baal86/ttgf-analog-openschnapp/xschem/README.txt

Do not use simulation -> LVS -> LVS netlist. Only: top level is subckt

Otherwise it will expand the MOSFETs and fail to locate the SPICE models
