baal86/ttgf-analog-openschnapp/docs/column_switch/README.md

## Column Switch
Select the column to be connected to the current source bus. The diode is only present to protect the large enable net during production (antenna diode).

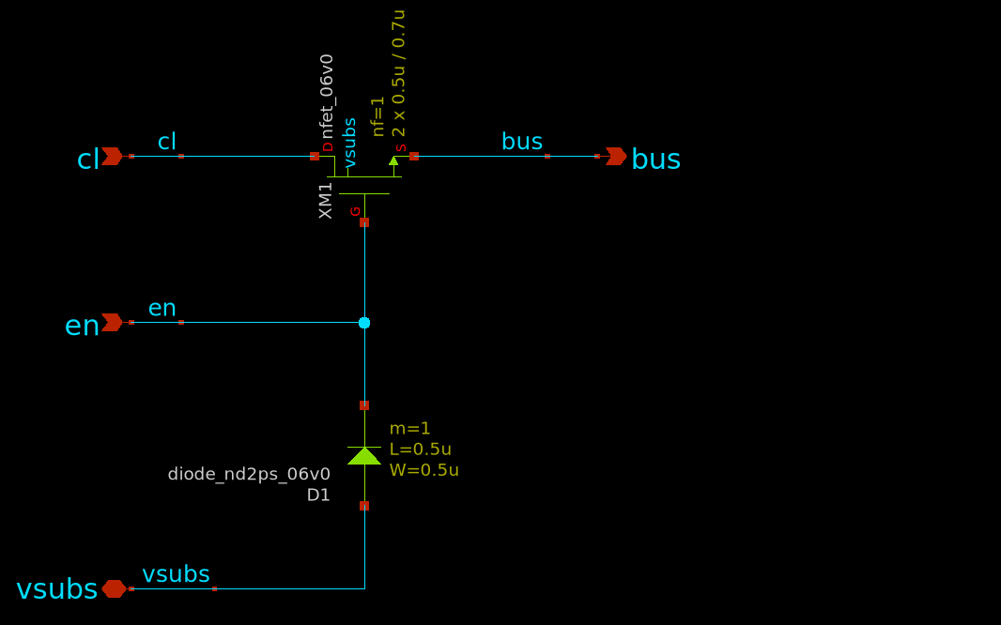
[picture p11: xschem/docs/ip_column_switch.png]
Schematics


### Transfer Function Simulation

AC transfer function is simulated. We aim for flat transfer function up to 1MHz when the switch is on and >80dB isolation when the switch is of. Note the significant difference in off-performance between ideal and post-layout simulation.

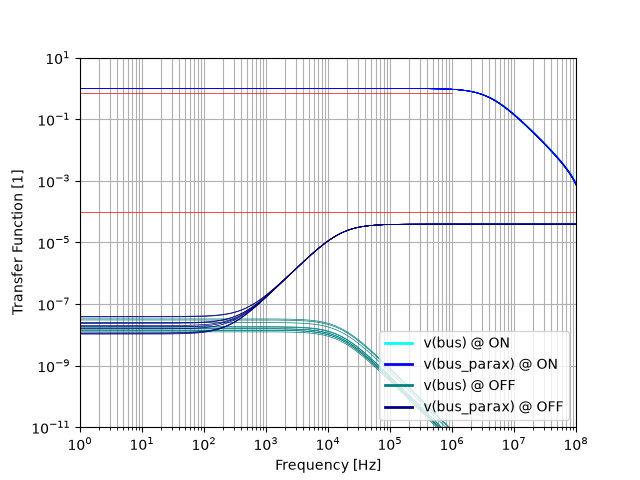
[picture p12: xschem/docs/tb_column_switch_ac.png]
AC Transfer Function
