baal86/ttgf-analog-openschnapp/docs/current_source/README.md

## Current Source
A low-side current source with two outputs, one for the pixel array, the other for the dummy pixel.

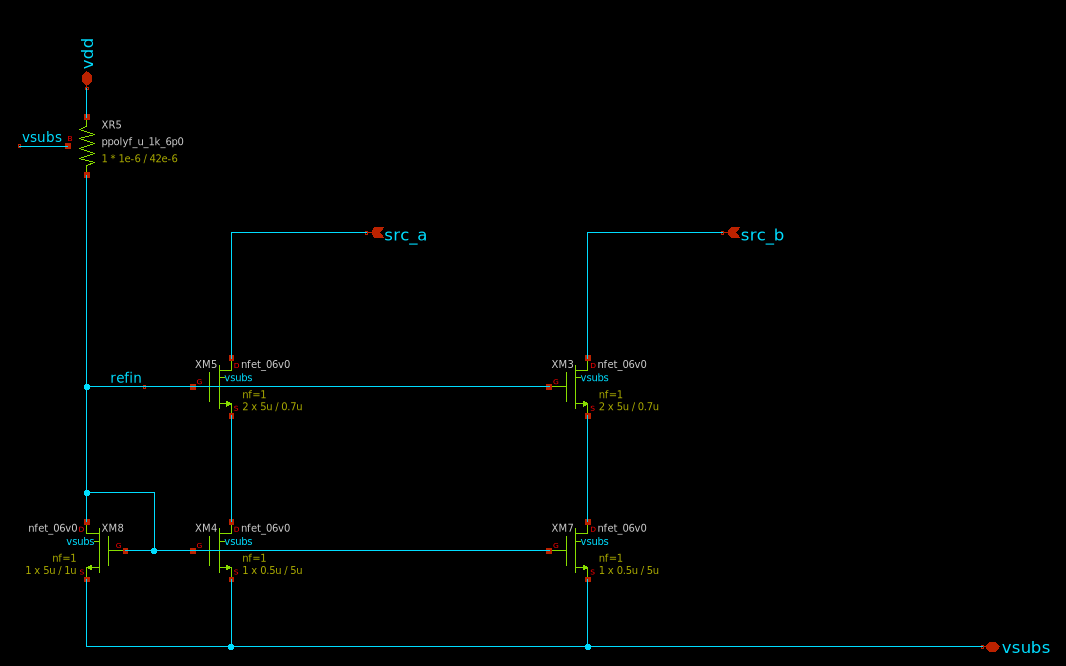
[picture p13: xschem/docs/ip_current_source.png]
Schematics


### Output Current Simulation

DC current output is simulated to be at 1uA under all conditions.

> View the test-bench on [https://xschem-viewer.com](https://xschem-viewer.com/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)

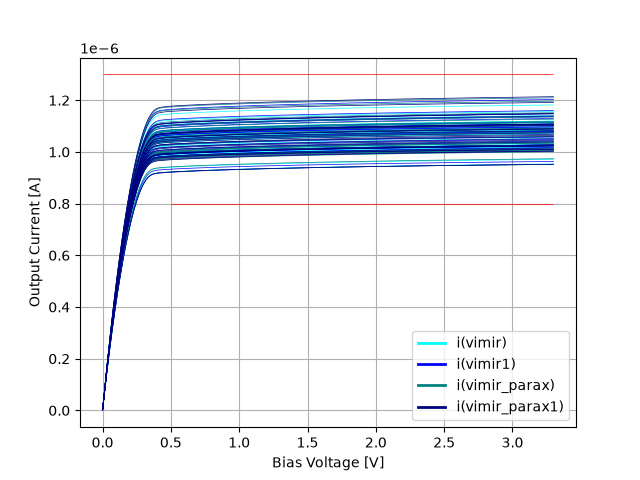
[picture p14: xschem/docs/tb_current_source_dc.png]
DC Current


### Output Impedance Simulation

Output impedance is simulated.

> View the test-bench on [https://xschem-viewer.com](https://xschem-viewer.com/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)

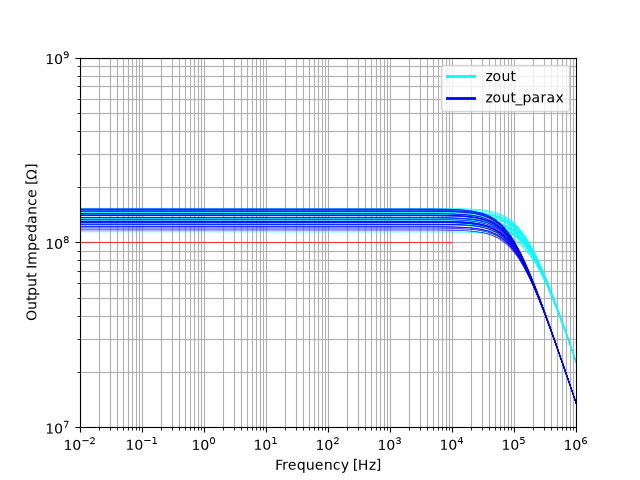
[picture p15: xschem/docs/tb_current_source_ac.png]
AC Impedance
