baal86/ttgf-analog-openschnapp/docs/total/README.md

## Total Simulation
A subset of the entire image sensor is simulated. This includes co-simulation of the digital parts.  The exposure time is 5ms, but injection currents are scaled up to compensate. A test pattern image is injected. The simulation implements correlated double sampling to compensate for the photons caught during integration and to reject kTC noise (not modelled).

> View the test-bench on [https://xschem-viewer.com](https://xschem-viewer.com/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)

A timing diagram of the digital signals, clock, reset, and column/row control is shown below.

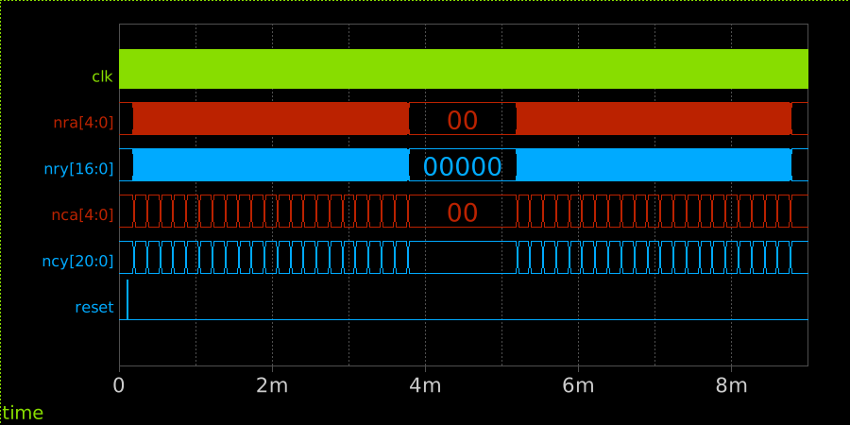
[picture p21: xschem/docs/tb_total_tran.a.png]
Timing Diagram


The analog signals are shown below:

- `ref` is the voltage of the reference pixel.
- `sf` is the unbuffered pixel voltage at the current source.
- `out` is the buffered video output.

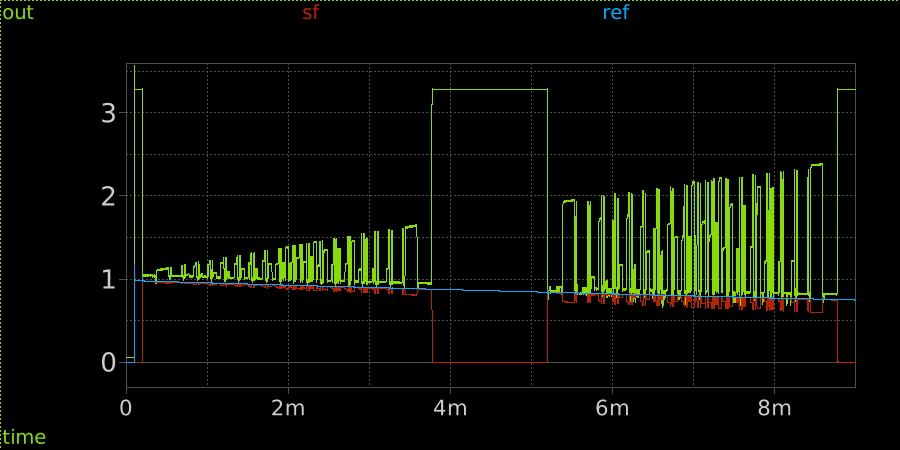
[picture p22: xschem/docs/tb_total_tran.b.png]
Analog Signals


The resulting image is shown below, quantized to 12bit @ 3.3V FSR as would be the case for the RP2350 ADC.

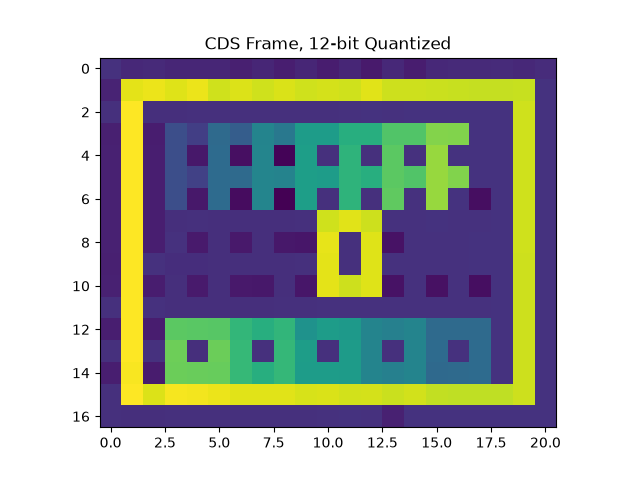
[picture p23: xschem/docs/tb_total_tran.png]
Samples Image
