baal86/ttgf-analog-openschnapp/docs/info.md

<!---

This file is used to generate your project datasheet. Please fill in the information below and delete any unused
sections.

You can also include images in this folder and reference them in the markdown. Each image must be less than
512 kb in size, and the combined size of all images must be less than 1 MB.
-->

## How it works

A classic 3T CMOS image sensor. Diode performance will be poor, but hopefully the readout can be demonstrated. 

Block Diagram

### Masked Pixels

Some pixel rows are masked by `metal5` power distribution structures generated by tiny tapeout, but the available pixels should allow characterization of the image sensor. `metal4` will be populated with a fine grid to hopefully prevent automatic filler generation in the pixel area on `metal4` and `metal5`. Unless the power bar generation algorithm changes from the TTGF-0p3 shuttle the following pixel rows should be available. There is an indicator bar on `metal4` next to the power distribution strips that indicates predicted `metal5` placement, solid bars being open and striped bars being masked.

| Rows  |  Status |
| ----- | --- |
| 16 | 🌑masked |
| 15,14 | 🌕open |
| 13 | 🌗50% open |
| 12,11 | 🌑masked |
| 10 | 🌗50% open |
| 9,8 | 🌕open |
| 7,6,5 | 🌑masked |
| 4,3 | 🌕open |
| 2 | 🌗50% open |
| 1,0 | 🌑masked |

So, in total, ~47% of pixels are masked, ~35% open and ~18% half-masked.

### Further Documentation

More documentation is avaialble in the repository itself. Further documentation for single IP blocks in the folders listed below.

- [https://github.com/baal86/ttgf-analog-openschnapp/blob/main/docs/pixel/README.md](https://github.com/baal86/ttgf-analog-openschnapp/blob/main/docs/pixel/README.md)
- [https://github.com/baal86/ttgf-analog-openschnapp/blob/main/docs/current_source/README.md](https://github.com/baal86/ttgf-analog-openschnapp/blob/main/docs/current_source/README.md)
- [https://github.com/baal86/ttgf-analog-openschnapp/blob/main/docs/column_mux/README.md](https://github.com/baal86/ttgf-analog-openschnapp/blob/main/docs/column_mux/README.md)
- [https://github.com/baal86/ttgf-analog-openschnapp/blob/main/docs/row_mux/README.md](https://github.com/baal86/ttgf-analog-openschnapp/blob/main/docs/row_mux/README.md)
- [https://github.com/baal86/ttgf-analog-openschnapp/blob/main/docs/column_switch/README.md](https://github.com/baal86/ttgf-analog-openschnapp/blob/main/docs/column_switch/README.md)
- [https://github.com/baal86/ttgf-analog-openschnapp/blob/main/docs/amplifier/README.md](https://github.com/baal86/ttgf-analog-openschnapp/blob/main/docs/amplifier/README.md)
- [https://github.com/baal86/ttgf-analog-openschnapp/blob/main/docs/signal_processing/README.md](https://github.com/baal86/ttgf-analog-openschnapp/blob/main/docs/signal_processing/README.md)
- [https://github.com/baal86/ttgf-analog-openschnapp/blob/main/docs/total/README.md](https://github.com/baal86/ttgf-analog-openschnapp/blob/main/docs/total/README.md)

## How to test

For simple uncorrelated readout:

- Apply a 200kHz clock to the `clk` pin of the chip. This synchronizes the column select, row select and reset signals.
- Pulse reset high, then low to reset the array using the `ui[5]` signal. The reset signal is latched at the rising edge of the chip clock.
- Wait for your desired integration time. Try 1ms to start with.
- Read out the image sensor. Do for each pixel in the array.
    - Address the pixel by row and column number using the `ui[4:0]` and `uio[4:0]` signals. Column and row select are latched at the rising edge of the chip clock.
    - After settling, sample the video output signal `ua[0]` or buffered signal `ua[1]` using the development board ADC. The falling edge of the chip clock is a suitable trigger signal, although it would be advantageous to choose a sample point right before the next pixel is addressed to maximize sample time.

More advanced readout modes like correlated double sampling (CDS) and up-the ramp should be possible but the capability of the image sensor for non-destructive read needs to be tested first for the latter.

The [overall simulation](https://github.com/baal86/ttgf-analog-openschnapp/blob/main/docs/total/README.md) shows example clock patters for correlated double sampling readout of the detector.
