baal86/ttgf-analog-openschnapp/docs/column_mux/README.md

## Column Multiplexer
A clock-synchronous 5:21 de-multiplexer that gives:

- No column activated if A[4:0] = 0b00000
- A single column activated for other values of A

The multiplexer is implemented in Verilog.

### Timing Diagram

Timing diagram to visualize functionality.

> View the test-bench on [https://xschem-viewer.com](https://xschem-viewer.com/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)

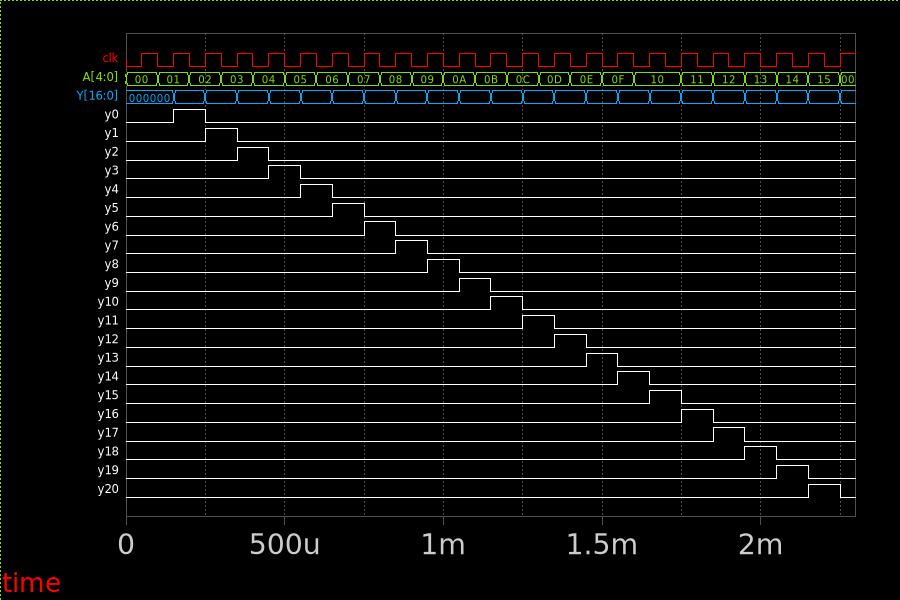
[picture p26: xschem/docs/tb_column_mux_timing.png]
Timing Diagram
