baal86/ttgf-analog-openschnapp/xschem/docs/ip_pixel_frame_right.png

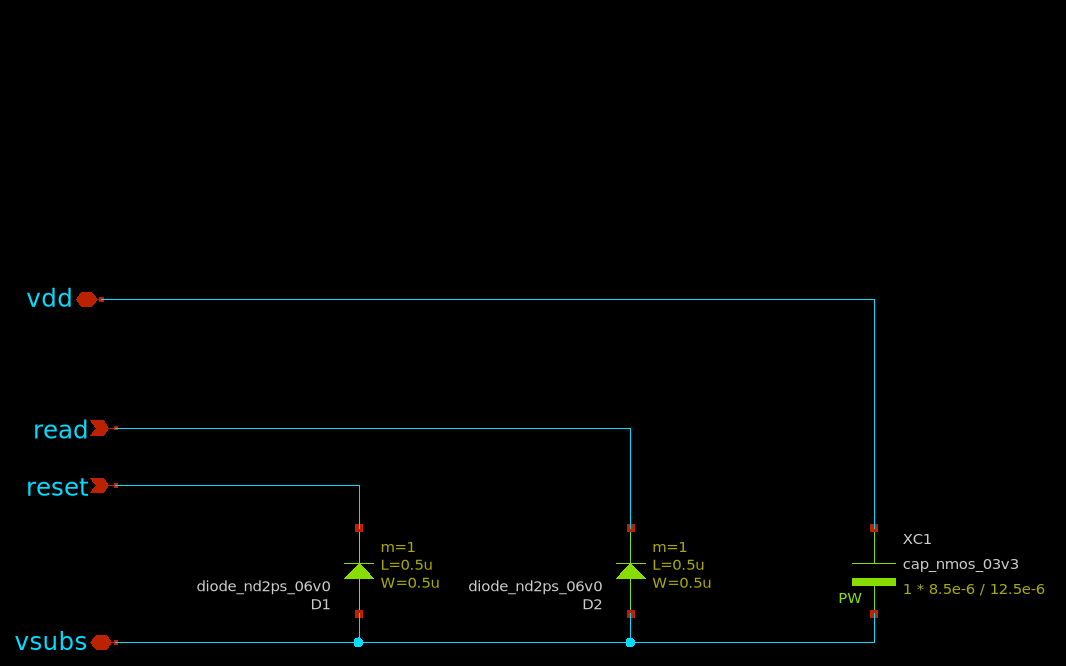
xschem/docs/ip_pixel_frame_right.png
