baal86/ttgf-analog-openschnapp/xschem/docs/ip_psucap_bottom.png

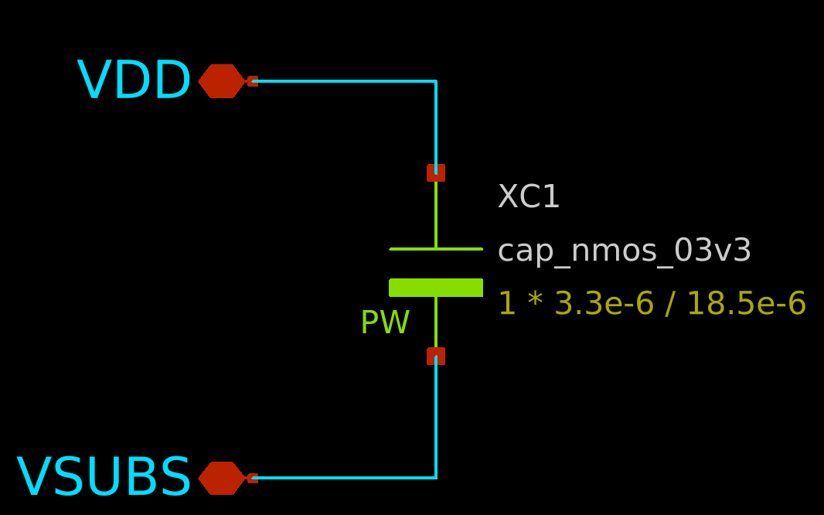
xschem/docs/ip_psucap_bottom.png
