baal86/ttgf-analog-openschnapp/xschem/docs/ip_psucap_br.png

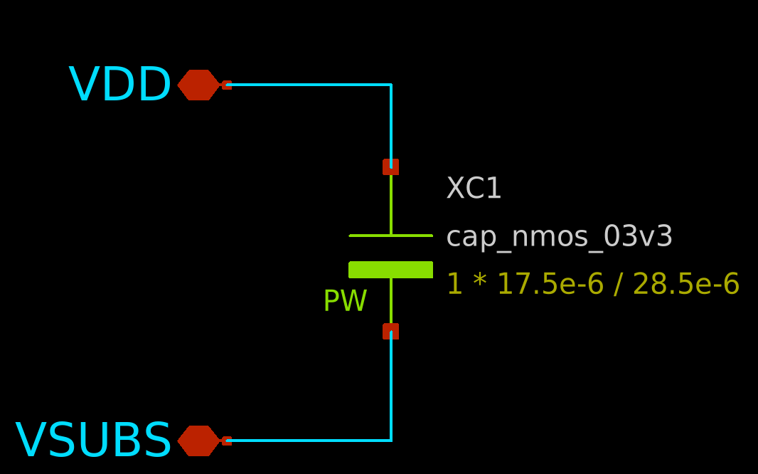
xschem/docs/ip_psucap_br.png
