baal86/ttgf-analog-openschnapp/xschem/lvs/ip_current_source.lvs.spice

** sch_path: /foss/designs/ttgf-analog-openschnapp/xschem/ip_current_source.sch
.subckt ip_current_source vdd src_a vsubs src_b
*.PININFO vdd:B vsubs:B src_a:I src_b:I
XM8 refin refin vsubs vsubs nfet_06v0 L=1u W=5u nf=1 ad='int((nf+1)/2) * W/nf * 0.18u' as='int((nf+2)/2) * W/nf * 0.18u' pd='2*int((nf+1)/2) * (W/nf + 0.18u)'
+ ps='2*int((nf+2)/2) * (W/nf + 0.18u)' nrd='0.18u / W' nrs='0.18u / W' sa=0 sb=0 sd=0
XM5 src_a refin net1 vsubs nfet_06v0 L=0.7u W=5u nf=1 ad='int((nf+1)/2) * W/nf * 0.18u' as='int((nf+2)/2) * W/nf * 0.18u' pd='2*int((nf+1)/2) * (W/nf + 0.18u)'
+ ps='2*int((nf+2)/2) * (W/nf + 0.18u)' nrd='0.18u / W' nrs='0.18u / W' sa=0 sb=0 sd=0 m=2
XM3 src_b refin net2 vsubs nfet_06v0 L=0.7u W=5u nf=1 ad='int((nf+1)/2) * W/nf * 0.18u' as='int((nf+2)/2) * W/nf * 0.18u' pd='2*int((nf+1)/2) * (W/nf + 0.18u)'
+ ps='2*int((nf+2)/2) * (W/nf + 0.18u)' nrd='0.18u / W' nrs='0.18u / W' sa=0 sb=0 sd=0 m=2
XM4 net1 refin vsubs vsubs nfet_06v0 L=5u W=0.5u nf=1 ad='int((nf+1)/2) * W/nf * 0.18u' as='int((nf+2)/2) * W/nf * 0.18u' pd='2*int((nf+1)/2) * (W/nf + 0.18u)'
+ ps='2*int((nf+2)/2) * (W/nf + 0.18u)' nrd='0.18u / W' nrs='0.18u / W' sa=0 sb=0 sd=0
XM7 net2 refin vsubs vsubs nfet_06v0 L=5u W=0.5u nf=1 ad='int((nf+1)/2) * W/nf * 0.18u' as='int((nf+2)/2) * W/nf * 0.18u' pd='2*int((nf+1)/2) * (W/nf + 0.18u)'
+ ps='2*int((nf+2)/2) * (W/nf + 0.18u)' nrd='0.18u / W' nrs='0.18u / W' sa=0 sb=0 sd=0
XR5 refin vdd vsubs ppolyf_u_1k_6p0 r_width=1e-6 r_length=42e-6
.ends
