baal86/ttgf-analog-openschnapp/verilog/gl/ip_column_mux.v

module ip_column_mux (clk,
    VDD,
    VSS,
    A,
    Y);
 input clk;
 inout VDD;
 inout VSS;
 input [4:0] A;
 output [20:0] Y;

 wire net1;
 wire net2;
 wire net3;
 wire net4;
 wire net5;
 wire net7;
 wire net8;
 wire net9;
 wire net10;
 wire net11;
 wire net12;
 wire net13;
 wire net14;
 wire net15;
 wire net16;
 wire net17;
 wire net18;
 wire net19;
 wire net20;
 wire net21;
 wire net22;
 wire net23;
 wire net24;
 wire net25;
 wire net26;
 wire net27;
 wire _00_;
 wire _01_;
 wire _02_;
 wire _03_;
 wire _04_;
 wire _05_;
 wire _06_;
 wire _07_;
 wire _08_;
 wire _09_;
 wire _10_;
 wire _11_;
 wire _12_;
 wire _13_;
 wire _14_;
 wire _15_;
 wire _16_;
 wire _17_;
 wire _18_;
 wire _19_;
 wire _20_;
 wire _21_;
 wire _22_;
 wire _23_;
 wire _24_;
 wire _25_;
 wire _26_;
 wire _27_;
 wire _28_;
 wire _29_;
 wire _30_;
 wire _31_;
 wire _32_;
 wire _33_;
 wire _34_;
 wire net6;
 wire net28;
 wire net29;
 wire net30;
 wire net31;
 wire net32;

 gf180mcu_fd_sc_mcu7t5v0__fill_1 FILLER_0_101 (.VDD(VDD),
    .VNW(VDD),
    .VPW(VSS),
    .VSS(VSS));
 gf180mcu_fd_sc_mcu7t5v0__fill_2 FILLER_0_104 (.VDD(VDD),
    .VNW(VDD),
    .VPW(VSS),
    .VSS(VSS));
 gf180mcu_fd_sc_mcu7t5v0__fill_1 FILLER_0_106 (.VDD(VDD),
    .VNW(VDD),
    .VPW(VSS),
    .VSS(VSS));
 gf180mcu_fd_sc_mcu7t5v0__fill_2 FILLER_0_150 (.VDD(VDD),
    .VNW(VDD),
    .VPW(VSS),
    .VSS(VSS));
 gf180mcu_fd_sc_mcu7t5v0__fillcap_4 FILLER_0_166 (.VDD(VDD),
    .VNW(VDD),
    .VPW(VSS),
    .VSS(VSS));
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
    .VPW(VSS),
    .VSS(VSS));
 gf180mcu_fd_sc_mcu7t5v0__buf_1 output8 (.I(net8),
    .Z(Y[10]),
    .VDD(VDD),
    .VNW(VDD),
    .VPW(VSS),
    .VSS(VSS));
 gf180mcu_fd_sc_mcu7t5v0__buf_1 output9 (.I(net9),
    .Z(Y[11]),
    .VDD(VDD),
    .VNW(VDD),
    .VPW(VSS),
    .VSS(VSS));
endmodule
