baal86/ttgf-analog-openschnapp/(commit log)

2026-08-24 One commit for privacy
    [ip_current_source.sch, ip_pixel_nd2ps.sch, tb_current_source.sch, tb_pixel_nd2ps.sch]
2026-08-24 Minimal change to update mail
    [tb_pixel_nd2ps.sch]
2026-08-25 Added pixel DC TF simulation and dropped reference current to 5uA
    [ip_current_source.sch, tb_pixel_nd2ps_dc.sch]
2026-08-25 Require the use of CTRL to fit graphs
    [tb_pixel_nd2ps_tran.sch]
2026-08-25 Fix LVS again by changing row select FET size
    [ip_pixel_nd2ps.sch]
2026-08-25 Added a noise sim. source follower FET needs to be larger!
    [ip_pixel_nd2ps.sch, tb_pixel_nd2ps_noise.sch]
2026-08-26 Added display of integral
    [tb_pixel_nd2ps_noise.sch]
2026-08-26 Stepped noise simulation with display @ 2.5V
    [tb_pixel_nd2ps_noise.sch]
2026-08-26 reduce load current and prevent inline editing .sch
    [ip_current_source.sch, tb_current_source.sch, tb_pixel_nd2ps_noise.sch]
2026-08-26 Transition to cascode at 1uA. Noise is better now and other simulations appear to work still.
    [ip_current_source.sch, tb_current_source.sch, tb_pixel_nd2ps_noise.sch, tb_pixel_nd2ps_tran.sch]
2026-08-26 fixed resistors choosing something producible
    [ip_current_source.sch]
2026-08-27 Bring current source to a more reasonable aspect ratio
    [ip_current_source.sch, tb_pixel_nd2ps_dc.sch]
2026-08-27 Added magic layout for current source block
2026-08-27 for manufacturability
    [ip_current_source.sch]
2026-08-27 Added parax for current source.
    [tb_current_source_ac.sch]
2026-08-27 Added MC simulation
    [ip_current_source.sch, tb_current_source_dc.sch]
2026-08-27 Less aggressive MC
    [tb_current_source_dc.sch]
2026-08-27 Full monte-carlo for the current source
    [tb_current_source_ac.sch, tb_current_source_dc.sch]
2026-08-27 transition sim to MC
    [tb_pixel_nd2ps_dc.sch]
2026-08-27 Cleaned tran sim
    [tb_pixel_nd2ps_tran.sch]
2026-08-27 Switch to custom area diode
    [ip_pixel_nd2ps.sch]
2026-08-27 hard-connect VRESET and VDD in xschem. Operating separate VDD and VRESET is not useful without extra protections.
    [ip_pixel_nd2ps.sch, tb_pixel_nd2ps_dc.sch, tb_pixel_nd2ps_noise.sch, tb_pixel_nd2ps_tran.sch]
2026-08-27 Increase size of SF MOSFET
    [ip_pixel_nd2ps.sch]
2026-08-27 clean up MOSFET data
2026-08-28 Added column switch
    [ip_column_switch.sch, tb_column_switch_ac.sch, tb_pixel_nd2ps_dc.sch, tb_pixel_nd2ps_noise.sch, tb_pixel_nd2ps_tran.sch]
2026-08-28 Fix column switch simulation
    [tb_column_switch_ac.sch]
2026-08-28 Column switch cell design
2026-08-28 Adjust column switch size
    [ip_column_switch.sch]
2026-08-28 Added 4:16 multiplexer block
    [ip_line_mux.sch, tb_line_mux.sch]
2026-08-28 migrate to Librelane
    [ip_line_mux.sch, pin_order.cfg, tb_line_mux.sch]
2026-08-28 Added make view and experimenting with die space
    [pin_order.cfg]
2026-08-31 Squeezed the mux a little bit
    [pin_order.cfg]
2026-08-31 co-simulation working (-ish)
    [tb_line_mux.sch]
2026-08-31 Co-simulation working in general but Y13 broken
    [tb_line_mux.sch]
2026-08-31 still debugging Y13
    [tb_line_mux.sch]
2026-08-31 added null for IO
    [tb_line_mux.sch]
2026-09-01 Remove siminj port
    [ip_pixel_nd2ps.sch, tb_pixel_nd2ps_dc.sch, tb_pixel_nd2ps_noise.sch, tb_pixel_nd2ps_tran.sch]
2026-09-01 Second supply rail not required.
2026-09-01 Branch to 3:6 column mux for saving space over 4:16 generic
    [pin_order.cfg]
2026-09-01 Insert smaller column mux
2026-09-01 Added row multiplexer
    [pin_order.cfg]
2026-09-01 Short unused digital I/O to VGND
    [project.v]
2026-09-01 fix GND tie up of the unused pads
    [project.v]
2026-09-01 made column switch tileable
2026-09-01 Added column switches
2026-09-01 Larger detector needs larger column muxes
    [pin_order.cfg]
2026-09-01 Added one more row of pixels in row mux
    [pin_order.cfg]
2026-09-01 Wired up row multiplexer
2026-09-01 Wire up column mux
2026-09-01 made diode contact smaller
2026-09-02 Added nw2ps diode
2026-09-02 Remove this diode. The .tech extract cannot handle nw2ps diodes
2026-09-02 Hopefully fixed verilog syntax error for precheck
    [project.v]
2026-09-02 fixed enable assignment within column block
    [column.v]
2026-09-02 fixed contact size so that power bars go within 10um of top boundary
2026-09-02 Updated verilog to have wire declarations as packed vector.
2026-09-02 Continued routing
    [pin_order.cfg]
2026-09-02 In the process of fixing top level LVS
    [project.v]
2026-09-02 Added powered verilog for muxes
    [pin_order.cfg]
2026-09-02 Added gate protection diodes to row and reset
2026-09-02 LVS pass after antenna diodes added to row and reset
    [ip_pixel_frame_right.sch]
2026-09-02 Add die snapshot image to README
    Added a die snapshot image to the README.
2026-09-03 Iterating over Metal4 Antennae
2026-09-03 Hopefully the antenna diodes are seen by Klayout now
2026-09-03 Fully framed the pixel area
2026-09-03 More rows in columns switch model
    [tb_column_switch_ac.sch]
2026-09-03 Added antenna diode at column switch gate
    [ip_column_switch.sch]
2026-09-03 Added experimental OP amp.
    [ex_amplifier.sch]
2026-09-03 conceptualizing an amplifier
    [ip_amplifier.sch, tb_amplifier.sch]
2026-09-03 Working on amplfier
    [ip_amplifier.sch, tb_amplifier.sch]
2026-09-03 Better biasing but not stable
    [ip_amplifier.sch, tb_amplifier.sch]
2026-09-04 Updated row mux cosim
    [tb_row_mux.sch]
2026-09-04 Clocked row mux added to the sim.
    [tb_row_mux.sch]
2026-09-04 Added reset signal latch
    [pin_order.cfg]
2026-09-04 Added reset latch
    [pin_order.cfg]
2026-09-04 routed rox/column control output side
    [pin_order.cfg]
2026-09-04 Routed but not yet fully compliant
    [pin_order.cfg]
2026-09-04 Fix LVS of antenna diodes
    [ip_column_switch.sch]
2026-09-04 finalizing LVS
    [pin_order.cfg]
2026-09-04 Added cosim for column mux
    [tb_column_mux.sch]
2026-09-04 OP amp shoudl be R2R capable
    [ip_amplifier.sch, tb_amplifier.sch]
2026-09-04 behaves like an OA now
    [tb_amplifier.sch]
2026-09-04 Check current for linearity
    [tb_pixel_nd2ps_dc.sch]
2026-09-07 Simplified amplifier using degenerate source diff stage
    [ip_amplifier.sch, tb_amplifier.sch]
2026-09-07 G=3 gain stage implemented
    [ip_amplifier.sch, tb_amplifier.sch]
2026-09-07 Added simulation suite for amplifier
    [tb_amplifier_dc.sch, tb_amplifier_noise.sch, tb_amplifier_tran.sch]
2026-09-07 Attempting total simulation
    [tb_total.sch]
2026-09-07 Added second port to current source
    [ip_current_source.sch, tb_current_source_dc.sch]
2026-09-07 2nd current source output routed
2026-09-07 Added initial update to 6.0V diode.
2026-09-07 Re-routed for 6.0V
    [ip_pixel_nd2ps.sch, tb_pixel_nd2ps_dc.sch]
2026-09-08 Fixed top level DRC issues caused by 6.0V FETs
2026-09-08 Adjusted simulations and double checked with the new 6.0V diodes
    [tb_pixel_nd2ps_noise.sch, tb_pixel_nd2ps_tran.sch]
2026-09-08 Initial attempt at simulating total detector readout for a 4x4 subsection
    [tb_total.sch]
2026-09-08 scaled graphs
    [tb_total.sch]
2026-09-08 Total detector simulation done fox 4x4 subarray
    [tb_total.sch]
2026-09-08 clean up pixel frame
2026-09-08 Clean-up pixel cell to get more space for diode
2026-09-08 changed diode to MV diode substrate contact
2026-09-08 Transition right side pixel frame to MV silicon
    [ip_pixel_frame_right.sch]
2026-09-08 changed entire pixel area to MV
    [ip_column_switch.sch]
2026-09-08 Full transition to 6.0V substrate connections in the pixel area
2026-09-08 Transition current source to 6V FETs
    [ip_current_source.sch, tb_current_source_ac.sch, tb_current_source_dc.sch]
2026-09-08 First iteration of ip_amplifier
    [ip_amplifier.sch]
2026-09-08 Intermediate commit between LVS passes
    [ip_amplifier.sch, tb_amplifier_dc.sch]
2026-09-08 LVS passes after adding missing taps
    [ip_amplifier.sch]
2026-09-09 Klayout DRC error free due to extra N-taps
    [project.v]
2026-09-09 Update current source to 6V0 resistors
    [ip_current_source.sch, tb_current_source_dc.sch]
2026-09-09 Compensate for higher resistance needed for 6.0V process
    [ip_current_source.sch]
2026-09-10 Remove P-well under diode to make a true nd2ps diode
2026-09-10 Remove old 3.3V diode no longer in use.
2026-09-10 Implemented pytest for current source
    [tb_current_source_ac.sch, tb_current_source_dc.sch]
2026-09-10 Auto-generate documentation PNGs
    [ip_current_source.sch]
2026-09-10 added info.md for current source
2026-09-10 Update image path for current source schematics
2026-09-10 Add description for low-side current source
2026-09-10 Add link to Current Source documentation
2026-09-10 Added analog pin capacitance to model.
    [tb_total.sch]
2026-09-10 Updated row and column multiplexer to have a defined 0b00000 state with no row/column active.
    [tb_column_mux.sch, tb_row_mux.sch]
2026-09-10 First step developing a buffer
    [ip_buffer.sch, tb_buffer_ac.sch, tb_buffer_dc.sch, tb_buffer_noise.sch, tb_total.sch]
2026-09-10 Added more stuff
    [ip_buffer.sch, tb_buffer_tran.sch]
2026-09-10 cranked up amplifier gain
    [ip_amplifier.sch, tb_amplifier_dc.sch]
2026-09-10 replace resistors with POLY1k_6V0
    [ip_buffer.sch]
2026-09-10 adjust component qty
    [ip_buffer.sch, tb_buffer_noise.sch]
2026-09-11 Documentation of current source
2026-09-11 Made pixel source follower as large as possible to reduce noise.
    [ip_pixel_nd2ps.sch]
2026-09-11 Documented pixel source follower DC TF
    [tb_pixel_nd2ps_dc.sch]
2026-09-11 Documented pixel reset voltage
    [tb_pixel_nd2ps_dc_reset.sch]
2026-09-11 Documented noise simulation
    [tb_pixel_nd2ps_noise.sch]
2026-09-11 Documented pixel transient
    [tb_pixel_nd2ps_tran.sch]
2026-09-11 Added generator for column mux documentation
    [tb_column_mux_timing.sch]
2026-09-11 Fix simulation range
    [tb_column_mux_timing.sch]
2026-09-12 Enhance README with detailed pixel design information
    Added additional information about pixel design, including calculations, source follower DC transfer function, pixel reset voltage, readout noise, and transient simulation.
2026-09-14 Added row multiplexer documentation
    [tb_row_mux_timing.sch]
2026-09-14 Documented column switch
    [tb_column_switch_ac.sch]
2026-09-14 Added A/D cosim to the total simulation setup
    [tb_total.sch]
2026-09-14 Refined graphics
    [tb_total.sch]
2026-09-14 Usign parax for entire total simulation
    [tb_total.sch]
2026-09-14 Added load capacitance
    [tb_total.sch]
2026-09-14 Started image render script
    [tb_total_tran.sch]
2026-09-14 Go to 10mus pixel time
    [tb_total_tran.sch]
2026-09-14 6x4 detector
    [tb_total_tran.sch]
2026-09-14 Simulate 8x6 detector
    [tb_total_tran.sch]
2026-09-15 Added autogenerated pixel array
    [tb_total_tran.sch]
2026-09-15 Autogenerate stimulus file as well
    [tb_total_tran.sch]
2026-09-15 Using custom d2a blocks
    [tb_total_tran.sch]
2026-09-15 Simulation of the entire detector in uncorrelated mode
    [tb_total_tran.sch]
2026-09-15 Implementing CDS
    [tb_total_tran.sch]
2026-09-16 experimenting with folded cascode OTA
    [ip_amplifier.sch, tb_amplifier_dc.sch]
2026-09-16 get rid of top load stage?
    [ip_amplifier.sch, tb_amplifier_dc.sch]
2026-09-16 this is a working OP amp for now..
    [ip_amplifier.sch, tb_amplifier_dc.sch]
2026-09-16 OP amp appears to work now
    [ip_amplifier.sch, tb_amplifier_dc.sch, tb_amplifier_noise.sch, tb_amplifier_tran.sch]
2026-09-16 manufacturable OP amp
    [ip_amplifier.sch, tb_amplifier_dc.sch]
2026-09-16 Working on stability
    [ip_amplifier.sch, tb_amplifier_ac.sch, tb_amplifier_noise.sch, tb_amplifier_tran.sch]
2026-09-16 more work on compensation
    [ip_amplifier.sch, tb_amplifier_ac.sch, tb_amplifier_tran.sch]
2026-09-16 AMplifier stable with external compensation
    [ip_amplifier.sch, tb_amplifier_ac.sch, tb_amplifier_dc.sch, tb_amplifier_tran.sch]
2026-09-16 MC simulation for amplifier
    [tb_amplifier_dc.sch, tb_amplifier_tran.sch]
2026-09-17 stable at last!
    [ip_amplifier.sch, tb_amplifier_ac.sch, tb_amplifier_dc.sch, tb_amplifier_noise.sch, tb_amplifier_tran.sch]
2026-09-17 amplifier can now be placed successfully
    [ip_amplifier.sch, tb_amplifier_dc.sch, tb_amplifier_noise.sch]
2026-09-17 Routed but no LVs yet
    [ip_amplifier.sch]
2026-09-17 Clean subcircuit LVS
    [ip_amplifier.sch]
2026-09-17 Still a property error
    [ip_amplifier.sch]
2026-09-17 Remove buffer
    [ip_buffer.sch, tb_buffer_ac.sch, tb_buffer_dc.sch, tb_buffer_noise.sch, tb_buffer_tran.sch]
2026-09-17 Added signal processing block
    [ip_sigproc.sch]
2026-09-18 Stable now. Optimize!!
    [ip_amplifier.sch, tb_amplifier_ac.sch, tb_amplifier_dc.sch, tb_amplifier_noise.sch, tb_amplifier_tran.sch, tb_amplifier_x1_ac.sch, tb_amplifier_x1_tran.sch]
2026-09-18 to 3V3
    [ip_amplifier.sch, tb_amplifier_dc.sch, tb_amplifier_x1_tran.sch]
2026-09-18 new style OP amp placed
    [ip_amplifier.sch, tb_amplifier_noise.sch]
2026-09-18 LVS is OK now
    [ip_amplifier.sch]
2026-09-18 TRacing LVS errors
    [ip_sigproc.sch, tb_sigproc_tran.sch]
2026-09-18 sorted pin order
2026-09-18 Still a poly-R is connected to VSUBS instead...
    [ip_sigproc.sch]
2026-09-19 Monte carlo sim for x1 op amp.
    [tb_amplifier_x1_ac.sch]
2026-09-19 Added monte-carlo sim over bias sweep for the amplfiers
    [tb_amplifier_x1_ac.sch, tb_amplifier_x4_ac.sch]
2026-09-21 Permanently added parax files.
    Added parax sim to amplifierd deisgn
    [tb_amplifier_dc.sch, tb_amplifier_x1_ac.sch, tb_amplifier_x1_tran.sch, tb_amplifier_x4_ac.sch, tb_amplifier_x4_tran.sch, tb_sigproc_tran.sch]
2026-09-21 Added sigproc to total simulation
    [tb_amplifier_dc.sch, tb_total_tran.sch]
2026-09-21 Found error whu x10 parax was not stable. also moved amplfier to x10 gain
    [ip_sigproc.sch, tb_amplifier_x10_ac.sch, tb_amplifier_x10_tran.sch, tb_sigproc_noise.sch, tb_sigproc_tran.sch]
2026-09-21 Added decoupling capacitors to left side power bar of pixels
    [ip_psucap_l.sch]
2026-09-21 clean up column switch xschem
    [ip_column_switch.sch]
2026-09-21 fixed explicit definition of parallel/serial components
    [ip_current_source.sch]
2026-09-21 Custom nmoscap frame
2026-09-21 Added bulk capacitance to right side of pixel array,
    [ip_pixel_frame_right.sch]
2026-09-21 Added large NMOSCAP to bottom right of IC
    [ip_psucap_br.sch]
2026-09-21 Get back into the die area
2026-09-22 Align ports with grid
    [ip_psucap_br.sch]
2026-09-22 Added amplifier transient simulations
    [tb_amplifier_x10_tran.sch, tb_amplifier_x1_tran.sch]
2026-09-22 Go to 10us pixel time for total transient sim.
    [tb_total_tran.sch]
2026-09-22 Adding DC simulations for amplifier
    [tb_amplifier_x10_dc.sch, tb_amplifier_x1_dc.sch]
2026-09-23 Fill right side pixel frame with metal3
2026-09-23 Right side pixel frame metal4 filling
2026-09-23 Create logic ladder PSU capacitor cell
    [ip_psucap_logic.sch]
2026-09-23 Added capacitors for logic circuits
2026-09-23 Cleaned up digital logic power routing
2026-09-23 Added bottom row of decoupling capacitors
    [ip_psucap_bottom.sch]
2026-09-24 Enhance documentation on CMOS image sensor characteristics
    Added details about masked pixels and their status, including a table summarizing the pixel availability. Updated further documentation links.
2026-09-24 Prepare column switch to make space for metal3 grid
2026-09-24 Removed this from main folder
    [ip_sigproc.sch]
2026-09-24 Documented signal processing circuit.
    [ip_sigproc.sch, tb_sigproc_tran.sch]
2026-09-24 Experiment if one can see the testbench viewer
    [ip_sigproc.sch]
2026-09-25 M2 power plane fill at bottom
2026-09-25 cleaned up right side pixel frame
2026-09-25 Added VDD measurement
    [tb_sigproc_tran.sch]
2026-09-25 Thicker M3 traces for analog signals
2026-09-25 fix nook in SF trace
2026-09-25 Bigger analog column bus trace
